drunkparsnip/-hr-ti-jaar-1---project-A---groep-5/opleverset/documenten/professionalSkills/Berend/zelf feedback Berend.jpg

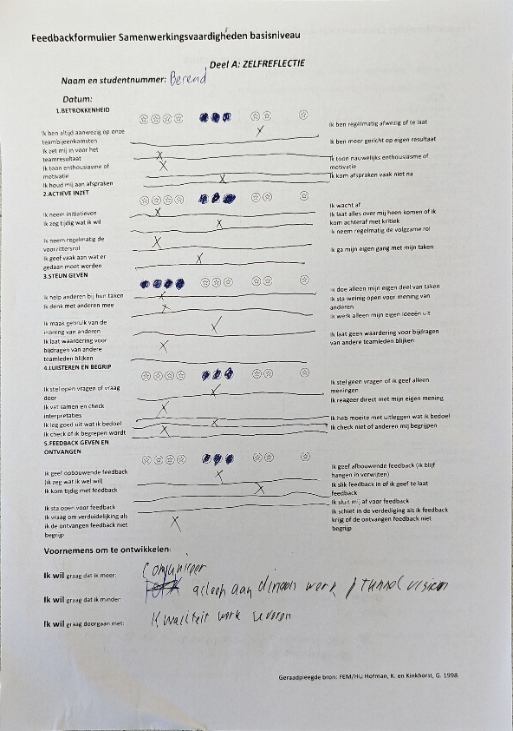
opleverset/documenten/professionalSkills/Berend/zelf feedback Berend.jpg
