drunkparsnip/-hr-ti-jaar-1---project-A---groep-5/opleverset/ontwerp/schetsen/eindversie/bovenaanzicht- onderste laag.jpg

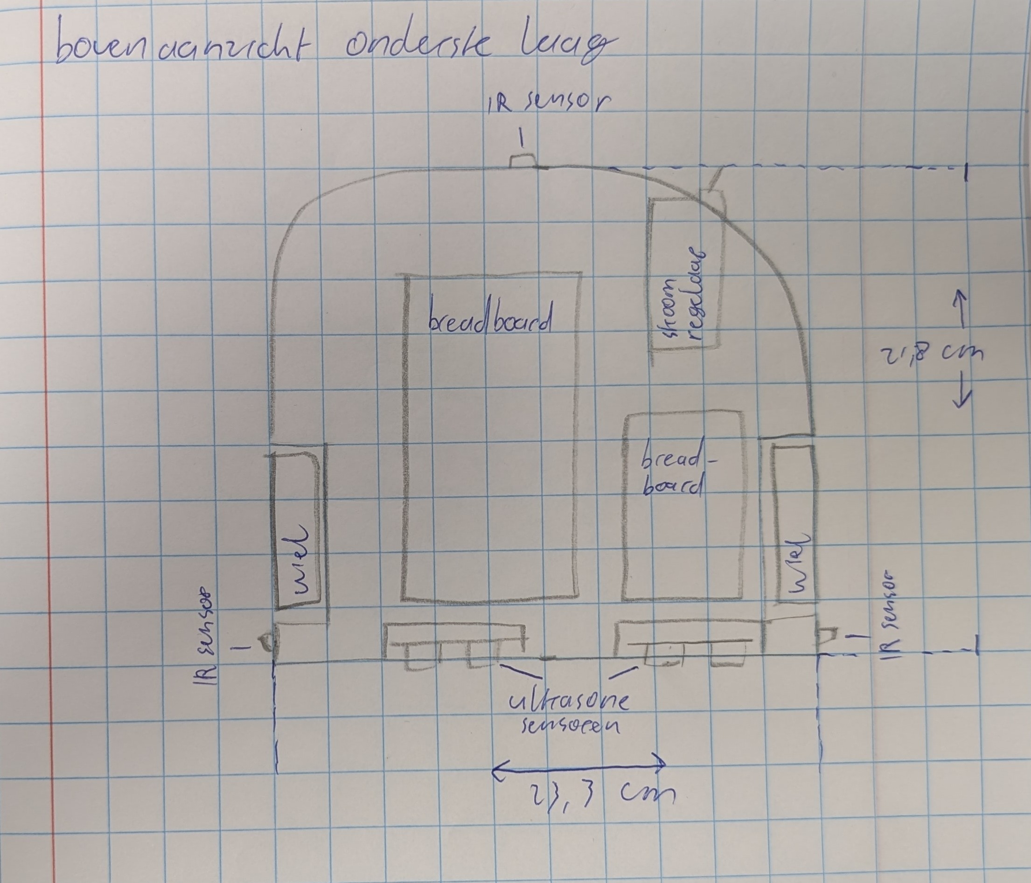
opleverset/ontwerp/schetsen/eindversie/bovenaanzicht- onderste laag.jpg
