drunkparsnip/-hr-ti-jaar-1---project-A---groep-5/README.md

# -hr-ti-jaar-1---project-A---groep-5
groep repository voor alles gerelateerd aan de APM
