drunkparsnip/-hr-ti-jaar-1---project-A---groep-5/documenten/Project A_ planning .pdf

# Planning groep 5 herkansingsperiode

Door: Berend, Sundus en Ivan Datum: 2/4/2026
Project: automatic package mover

De planning beslaat de herkansingsperiode van ongeveer 4 weken, van 26 maart tot 22 april. In het schema staat geen informatie over schoollessen of workshops, het is uitsluitend bedoeld voor studietijd buiten school. Dit is gemaakt voor project A (automatic package mover). Er is een algemene planning voor de hele groep per week, per week worden de taken verdeeld en uiteindelijk samengevoegd. Aan het einde van elke integratie wordt getest of alles werkt.

Hardware: accu, 8 sensors(ir sensor 2, ultrasoon sensor 1,microswitch 4, RFID sensor), noodknop, startknop, led, microcontroller(ESP23), draden, wielen en knop voor 7 verschillende gangen, arduino, motordriver L293D, 7 segment, breadbord, metalen Mad wiel, dc motor.

Vijf onderdelen hebben een elektrisch schema nodig, (sensors, noodknop, startknop, leds, knoppen).

Software:
1. lijnen detecteren en vermijden.
2. Obstakels en andere APM’s ontwijken.
3. Bij de rand van de balustrade keren.
4. RFID tags op het terrein detecteren als herkenningspunten.
5. Autonoom rijden.
6. Noodknop voor het direct stoppen van APM.
7. Startknop om te laten starten.
8. De status van de robot laten zien doormiddel van verschillende kleuren leds.
9. Kan opdracht krijgen d.m.v knoppen bovenop voor 7 verschillende gangen.
10. Kan naar de aangegeven locatie rijden om daar een pakket te ontvangen.
11. Kan detecteren dat er een pakket is geplaatst.
12. De pakketten naar het eindpunt vervoeren.

Elk groepslid moet aan 4 eisen werken.

APM:
1. Moet robuust zijn.
2. Kan 4 pakketten van 100 bij 50 bij 50 mm vervoeren.
3. Kan over heuvels rijden.
4. Breedte kleiner dan 20 cm.
5. Hardware en knoppen moeten op een stevig manier gemonteerd worden.

Tijd | Taak | Controle/ checklijst
2-9 april | navigatie IR sensor en DC motoren, start en noodknop
9-16 april | RFID, ultrasoon, pakket detectie
16-22 april | Routeknoppen, status aanduiding

Ontwerpen: elektrisch shema of een schets + (vorm, gewicht, materiaal + hoe de accu en sensors met draden en microcontroller aan de binnenkant moeten + hoe de leds en knoppen aan de buitenkant moet zitten).

Programmeren:
De eisen 14,15,16 en 17 lezen.

Hardware:
1. maak elektrisch schema eis nummer 14
2. test of het werkt

Documentatie:
1. demofilm
2. overdrachtsdocumentatie ( | )
