drunkparsnip/-hr-ti-jaar-1---project-A---groep-5/opleverset/documenten/Project A planning.pdf

# Planning groep 5 herkansingsperiode

Door: Berend, Sundus en Ivan Datum: 2/4/2026
Project: automatic package mover

De planning beslaat de herkansingsperiode van ongeveer 4 weken, van 26 maart tot 22 april. In het schema staat geen informatie over schoollessen of workshops, het is uitsluitend bedoeld voor studietijd buiten school. Dit is gemaakt voor project A (automatic package mover). Er is een algemene planning voor de hele groep per week, per week worden de taken verdeeld en uiteindelijk samengevoegd. Aan het einde van elke integratie wordt getest of alles werkt.

Hardware: accu, 3 ir sensoren, 2 ultrasoon sensoren, 8 microswitches, RFID sensor, noodknop, startknop, routeselectie knop, RGB led, 2 microcontrollers(ESP32), draden, motordriver L293D, bitshifter, breadboard, metalen wiel, 2 dc motoren en 2 wielen.

Software:
1. lijnen detecteren en vermijden.
2. Obstakels en andere APM’s ontwijken.
3. Bij de rand van de balustrade keren.
4. RFID tags op het terrein detecteren als herkenningspunten.
5. Autonoom rijden.
6. Noodknop voor het direct stoppen van APM.
7. Startknop om te laten starten.
8. De status van de robot laten zien doormiddel van verschillende kleuren leds.
9. Kan opdracht krijgen d.m.v knoppen bovenop voor 7 verschillende gangen.
10. Kan naar de aangegeven locatie rijden om daar een pakket te ontvangen.
11. Kan detecteren dat er een pakket is geplaatst.
12. De pakketten naar het eindpunt vervoeren.

Elk groepslid moet aan 4 eisen werken.

APM:
1. Moet robuust zijn.
2. Kan 4 pakketten van 100 bij 50 bij 50 mm vervoeren.
3. Kan over heuvels rijden.
4. Hardware en knoppen moeten op een stevig manier gemonteerd worden.

Planning APM

Tijd | Taak
2-9 april | DC motoren, documentatie
9-16 april | ultrasoon, IR sensoren, pakket detectie
16-22 april | RFID, state machine, startknop, noodknop, status indicatie.

Planning documentatie

Tijd | Taak
2-9 april | Schetsen en elektrisch schema
9-16 april | ontwerpdocument
16-22 april | Acceptatietesten, reflectie en feedbackformulieren

### Changelog Datum

| Versie | Verandering
2 -4 -2026 | 1.0 | Eerste planning
17 -4 -2026 | 2.0 | Taken ver plaatst
