drunkparsnip/-hr-ti-jaar-1---project-A---groep-5/opleverset/documenten/professionalSkills/observatieformulieren feedback.pdf

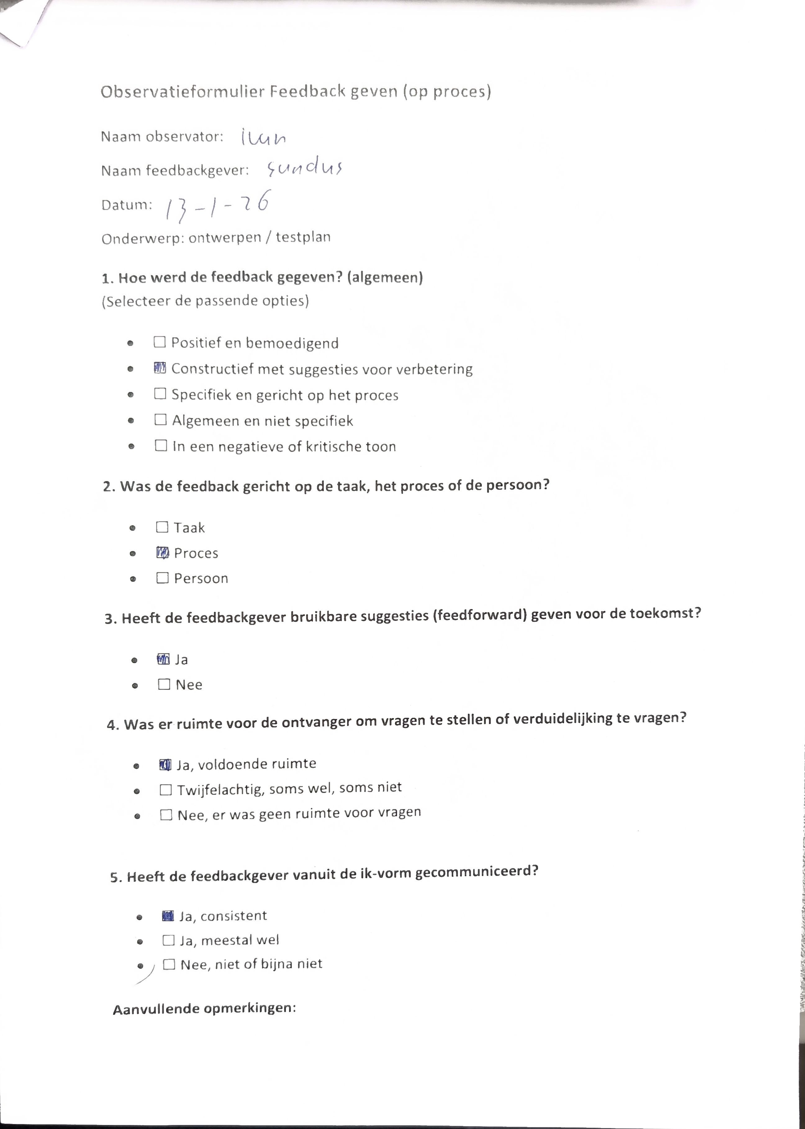
[picture p20: page 1]
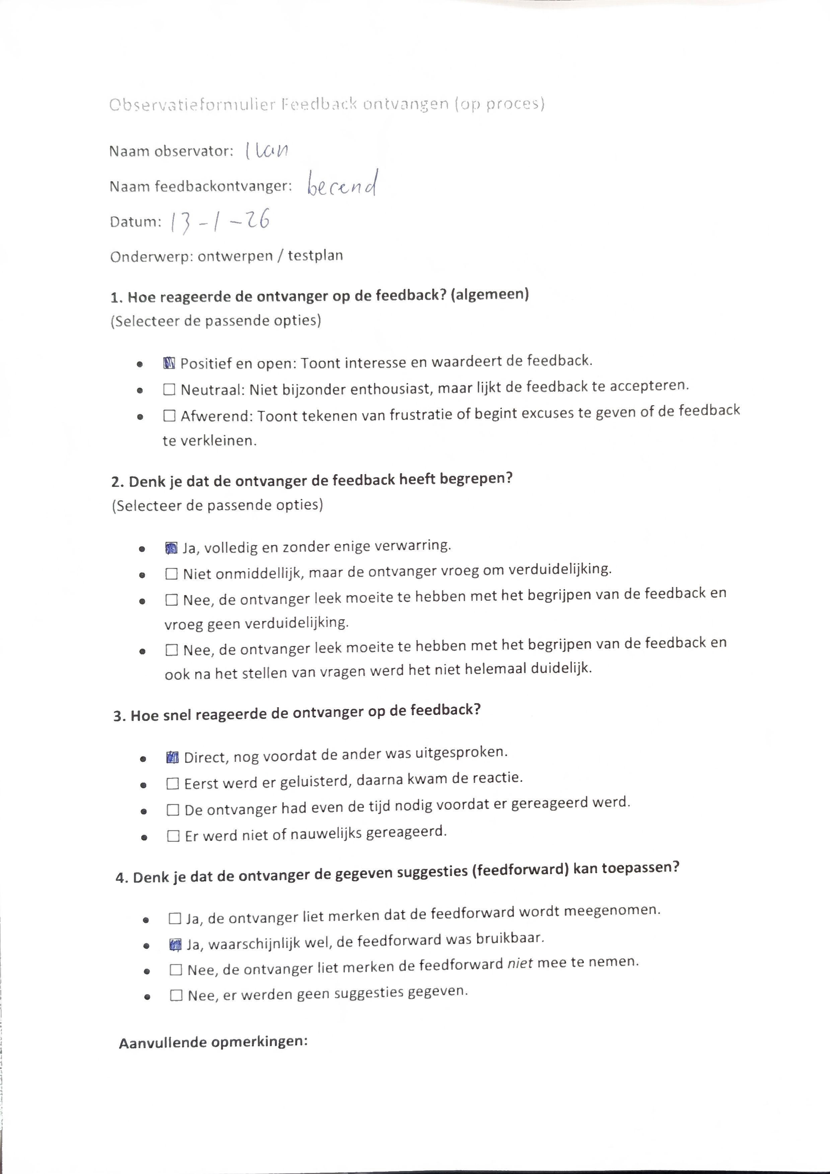
[picture p21: page 2]
