drunkparsnip/-hr-ti-jaar-1---project-A---groep-5/opleverset/ontwerp/schetsen/versie 1/AchterkantAPM.jpg

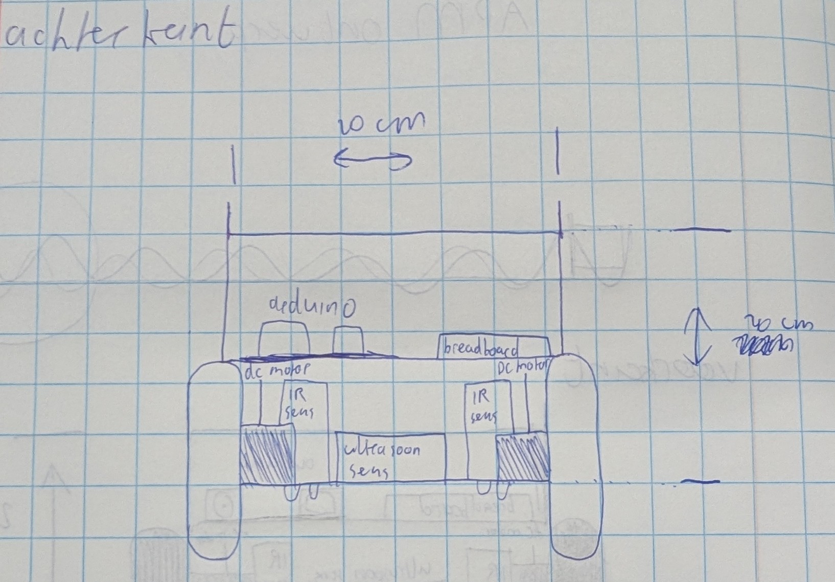
opleverset/ontwerp/schetsen/versie 1/AchterkantAPM.jpg
