drunkparsnip/-hr-ti-jaar-1---project-A---groep-5/opleverset/ontwerp/schetsen/versie 1/ZijkantAPM.jpg

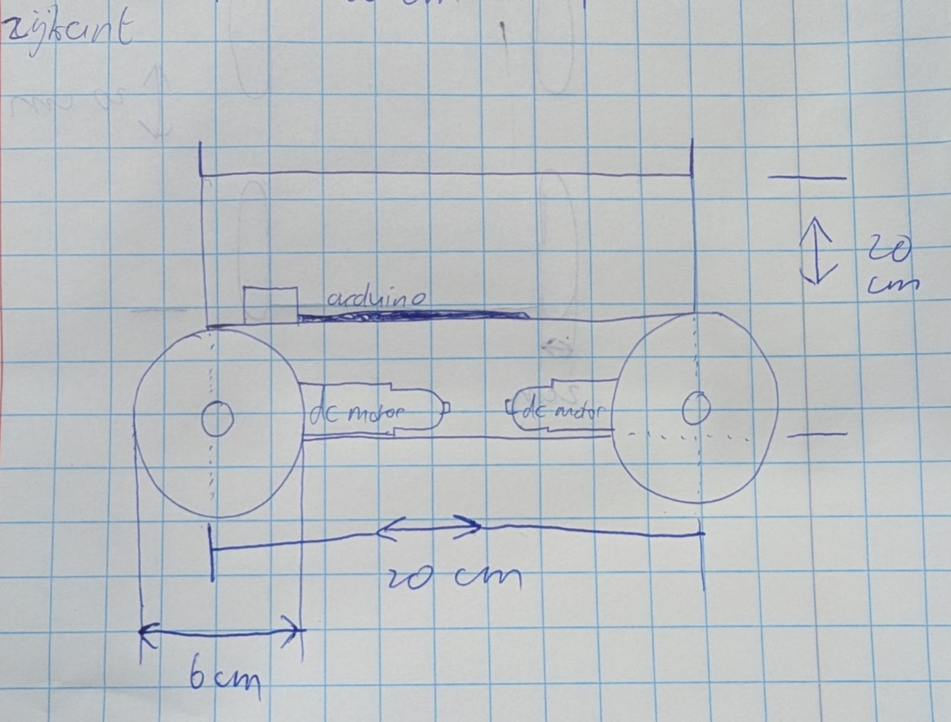
opleverset/ontwerp/schetsen/versie 1/ZijkantAPM.jpg
