drunkparsnip/-hr-ti-jaar-1---project-A---groep-5/opleverset/ontwerp/schetsen/versie 2/bovenaanzicht.jpg

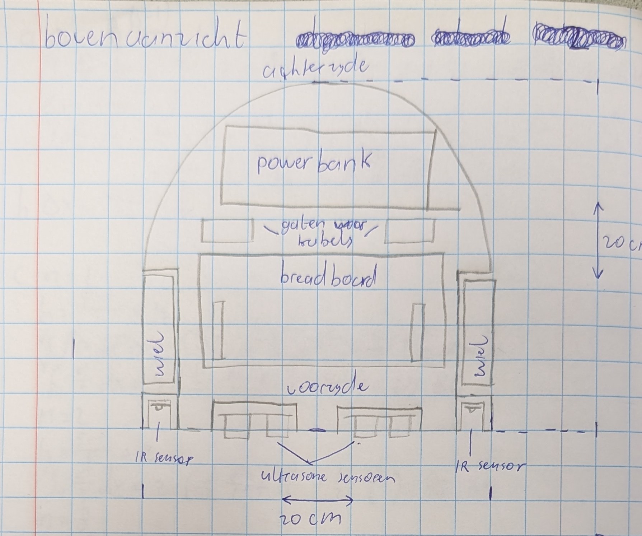
opleverset/ontwerp/schetsen/versie 2/bovenaanzicht.jpg
