drunkparsnip/-hr-ti-jaar-1---project-A---groep-5/ontwerpen/3d models/main assembly.stl

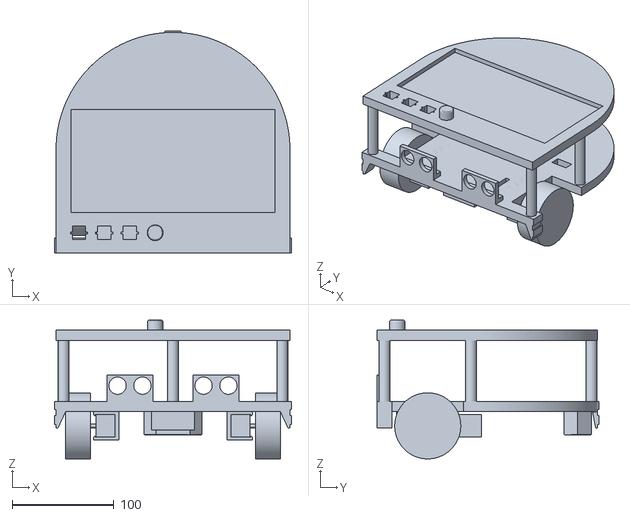
[picture p31: CAD file, 2026-03-04]
ontwerpen/3d models/main assembly.stl
233.0 x 218.5 x 136.5
