drunkparsnip/-hr-ti-jaar-1---project-A---groep-5/ontwerpen/3d models/cargo carier frame.step

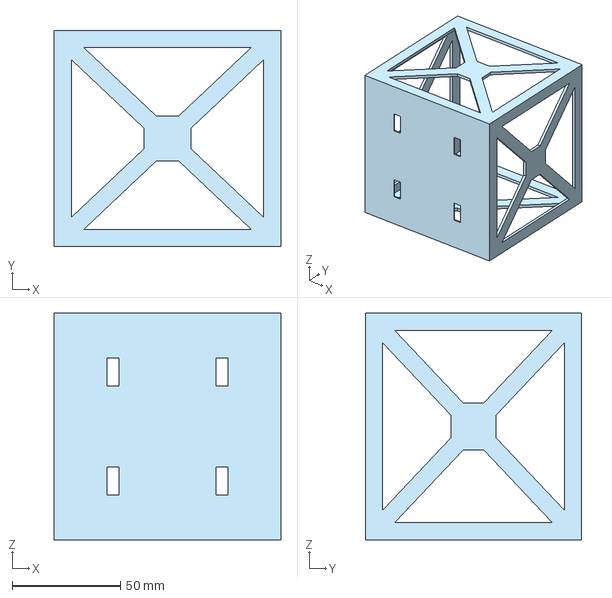
[picture p32: CAD file, 2025-12-02]
ontwerpen/3d models/cargo carier frame.step
105.0 x 100.0 x 105.0 mm
