drunkparsnip/-hr-ti-jaar-1---project-A---groep-5/ontwerpen/3d models/DC-motor-yellow (1).step

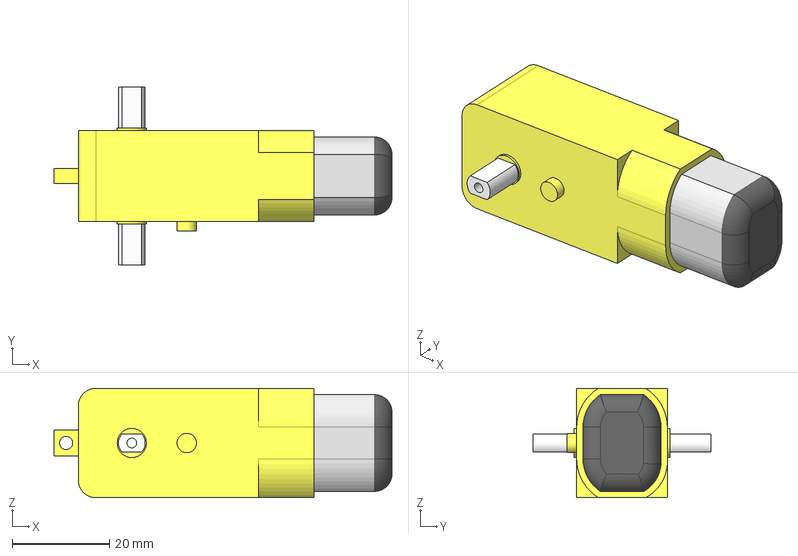
[picture p33: CAD file, 2025-12-02]
ontwerpen/3d models/DC-motor-yellow (1).step
69.5 x 36.7 x 22.5 mm
