drunkparsnip/-hr-ti-jaar-1---project-A---groep-5/opleverset/ontwerp/APM project A elektrisch schema.pdf

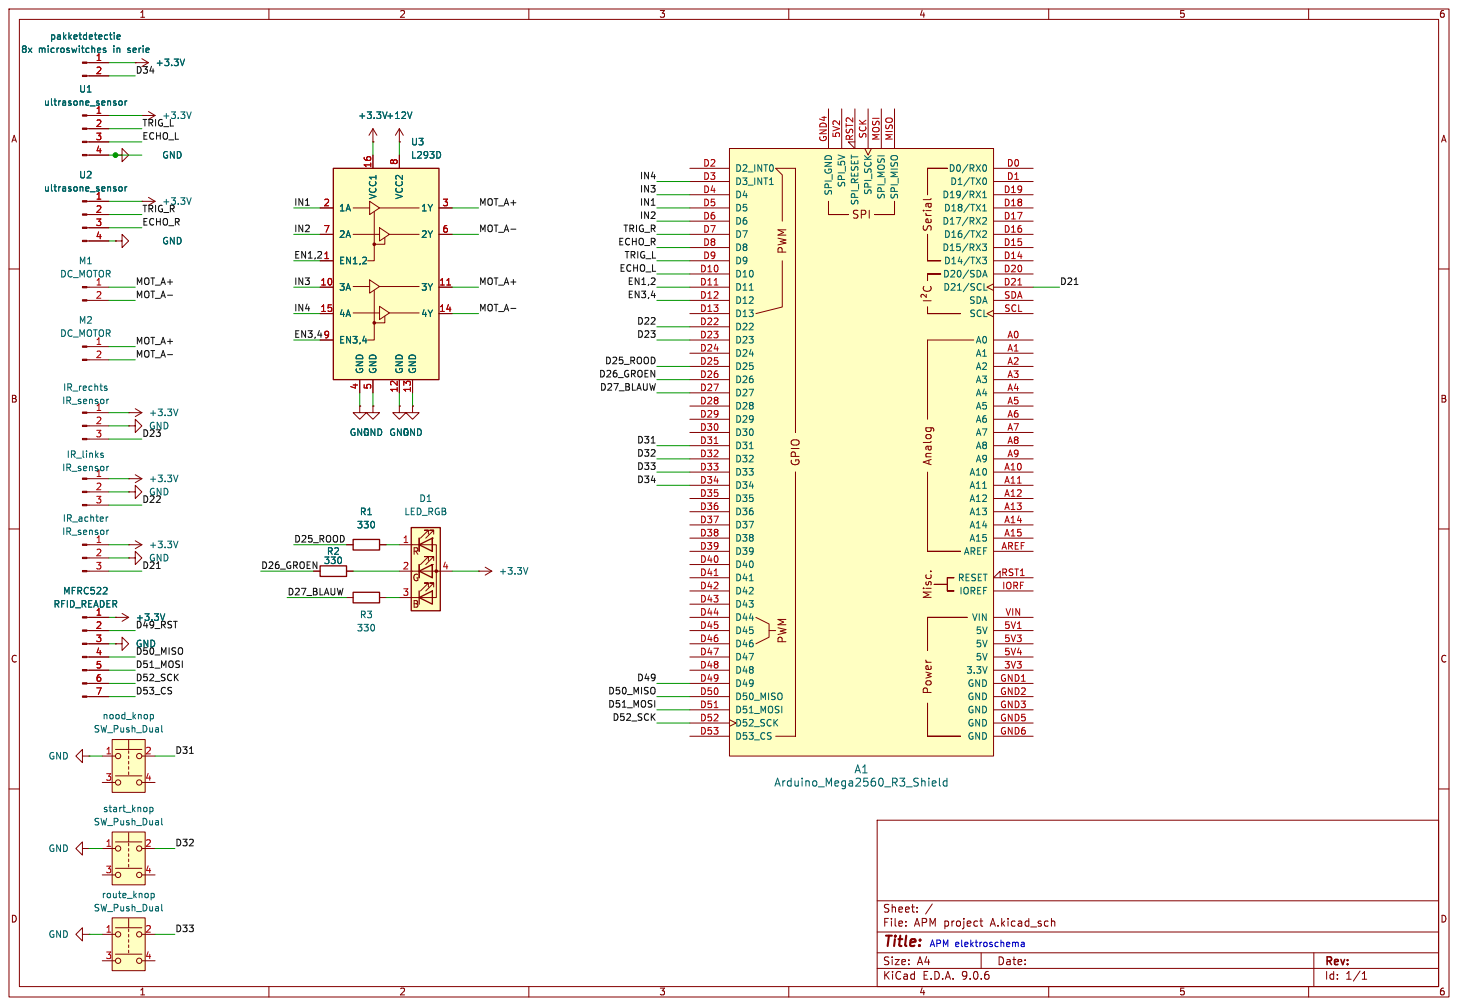
[picture p35: page 1]

SPI GPIO PWM PWM
