drunkparsnip/-hr-ti-jaar-1---project-A---groep-5/documenten/main assembly Drawing.pdf

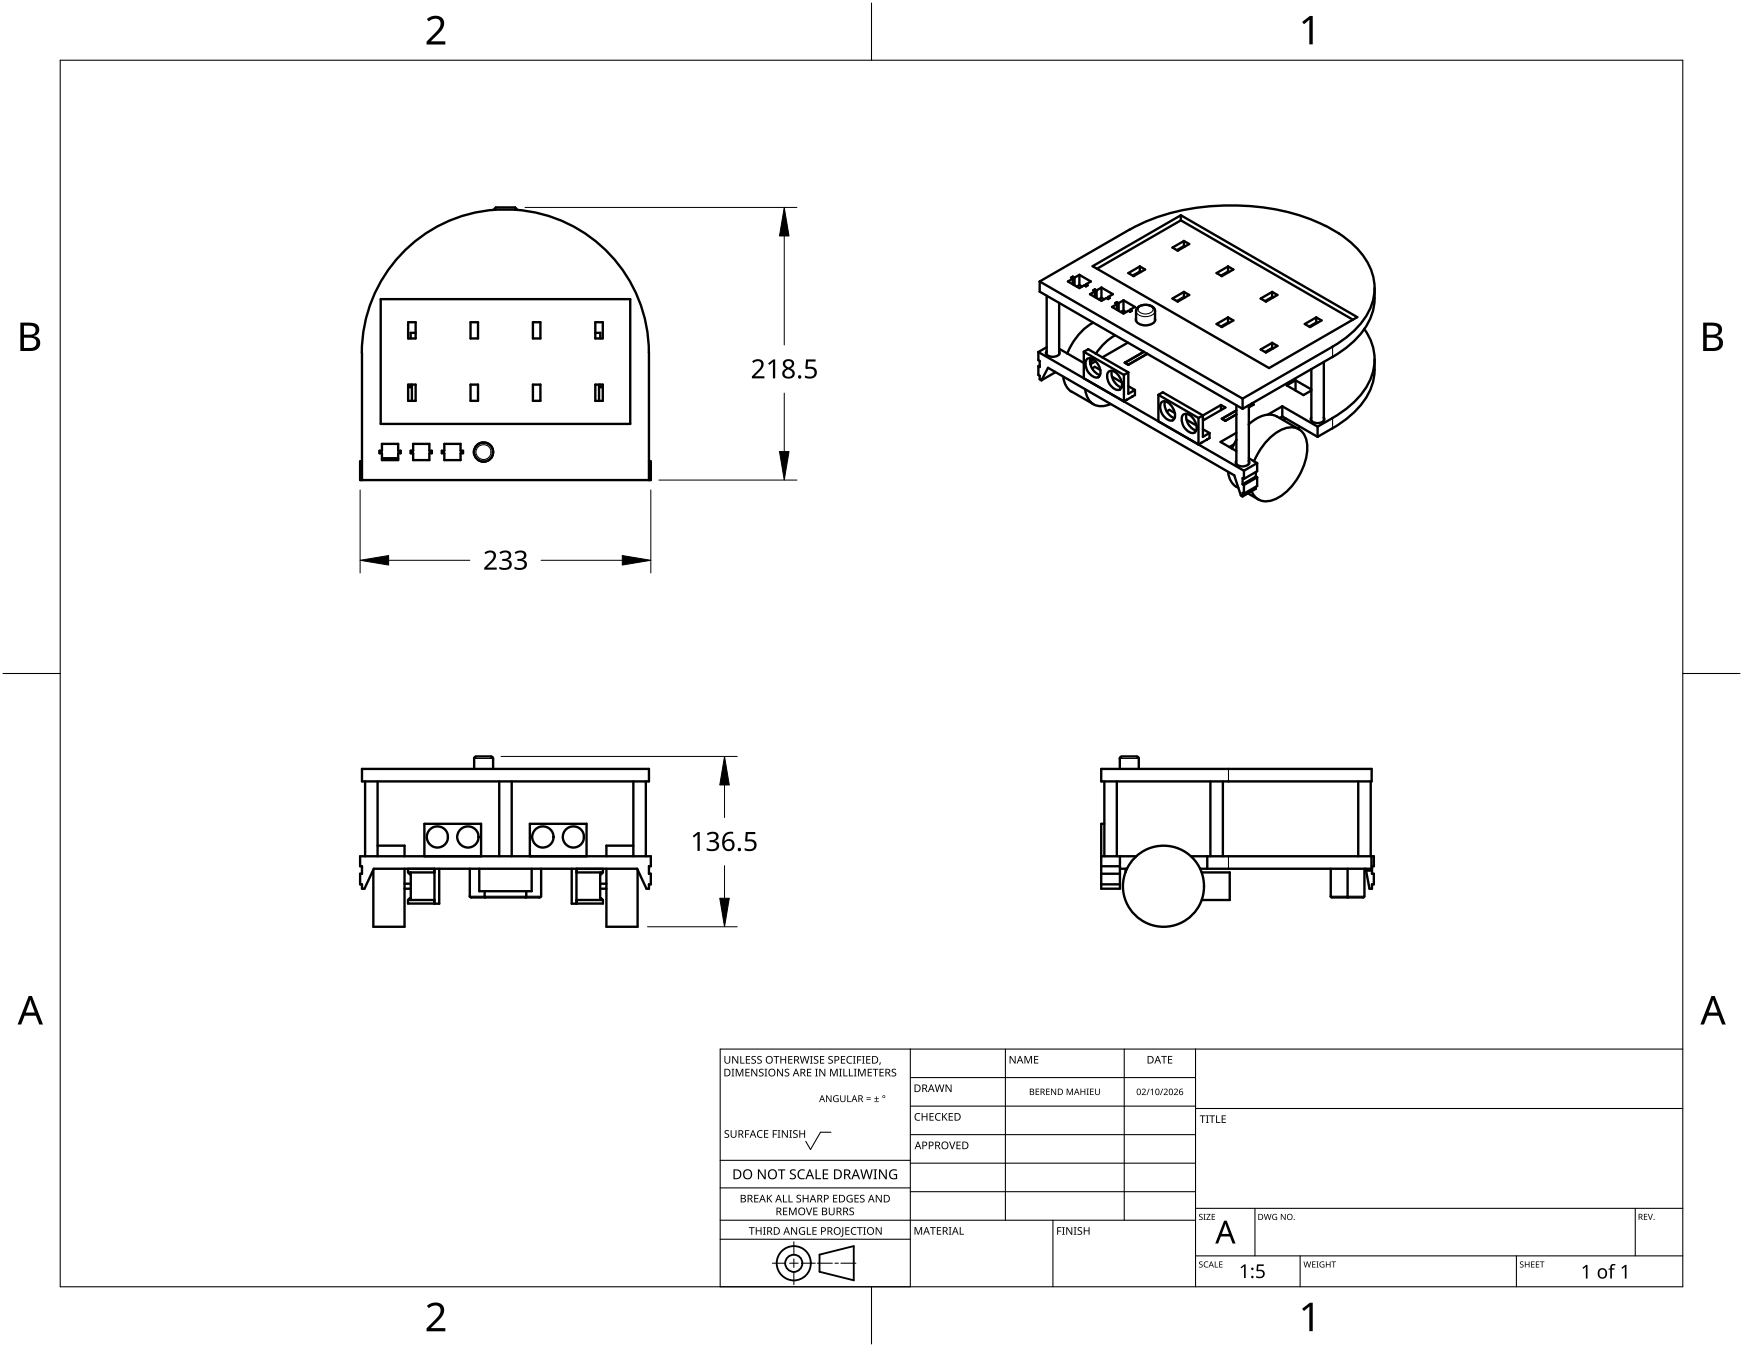
[picture p36: page 1]
