drunkparsnip/-hr-ti-jaar-1---project-A---groep-5/(list of files, drawings)

Other design files:
code/MFRC522/doc/fritzing/Arduino-Uno-r3-with-RFID-RC522.fzz
