drunkparsnip/-hr-ti-jaar-1---project-A---groep-5/(commit log)

2025-11-27 toevoeging van kicad files, 3d files en basic mappen structuur
    [cargo carier frame.step, project_A.kicad_pcb, project_A.kicad_sch]
2025-11-27 toevoeging van een code bestand zodat de map code zichtbaar is
2025-12-02 toevoeging van een code bestand zodat de map code zichtbaar is
    updated 3d files and kicad file progress
2025-12-02 verdere updates
    toevoeging van 3d file en aanpassing kicad files
    [DC-motor-yellow (1).step, cargo carier frame.step, project_A.kicad_sch]
2025-12-16 arduino ide code
    added an arduino ide code file
2026-01-27 code update
    working code for motors and ultrasonics added
2026-02-03 Create besturingMetIRSensor.ino.ino
    besturing met ir sensoren code
2026-02-10 code voor achterste IR sensor toegevoegd
2026-03-03 esp variant toegevoegd
    esp variant van de code gemaakt en ultrasoon geintergreerd
2026-03-04 code updates
    [main assembly.stl]
2026-03-04 toevoeging 2e microcontroler en herstructuering van de main code
2026-04-12 ontwerpdocu, elektrisch schema, map layout
    [APM project A.kicad_pcb, APM project A.kicad_sch, DC-motor-yellow (1).step, cargo carier frame.step, main assembly.stl, project_A.kicad_pcb, project_A.kicad_sch]
2026-04-16 opleverset deels gemaakt
    [APM project A.kicad_sch]
2026-04-17 elektrisch schema aangepast
    [APM project A.kicad_sch]
2026-04-17 switch naar arduino mega, arduino ide code versie, elektrisch schema verwijderd
    [APM project A.kicad_sch]
2026-04-20 ontwerpdocument aangepast
    [APM project A.kicad_sch]
2026-04-20 IR sensor, ultrasone sensor code werkend. laatste aanpassing elektrisch schema
    [APM project A.kicad_sch]
2026-04-20 toevoeging van vscode arduino mega apm
2026-04-20 mfrc library
    [Arduino-Uno-r3-with-RFID-RC522.fzz]
